joeljeske/reversi/schematics/GameBoardSchematic.png

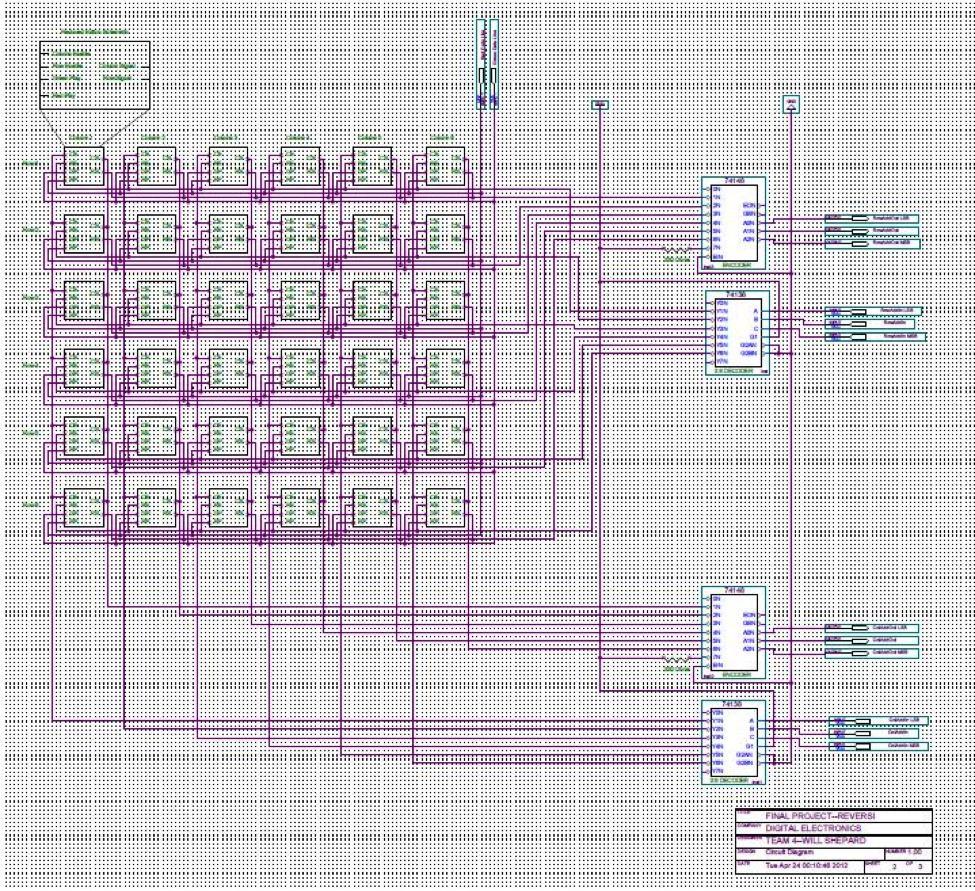
schematics/GameBoardSchematic.png
