joeljeske/reversi/schematics/CPLD-RAMSchematic.png

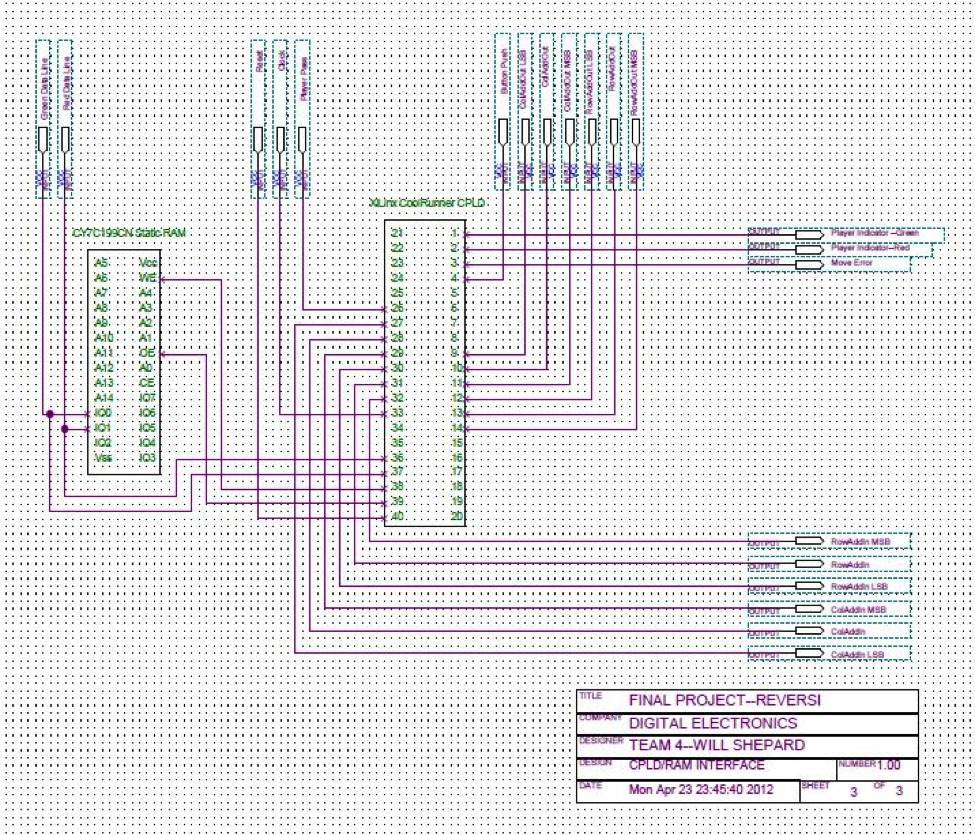
schematics/CPLD-RAMSchematic.png
