joeljeske/reversi/schematics/ButtonSchematic.png

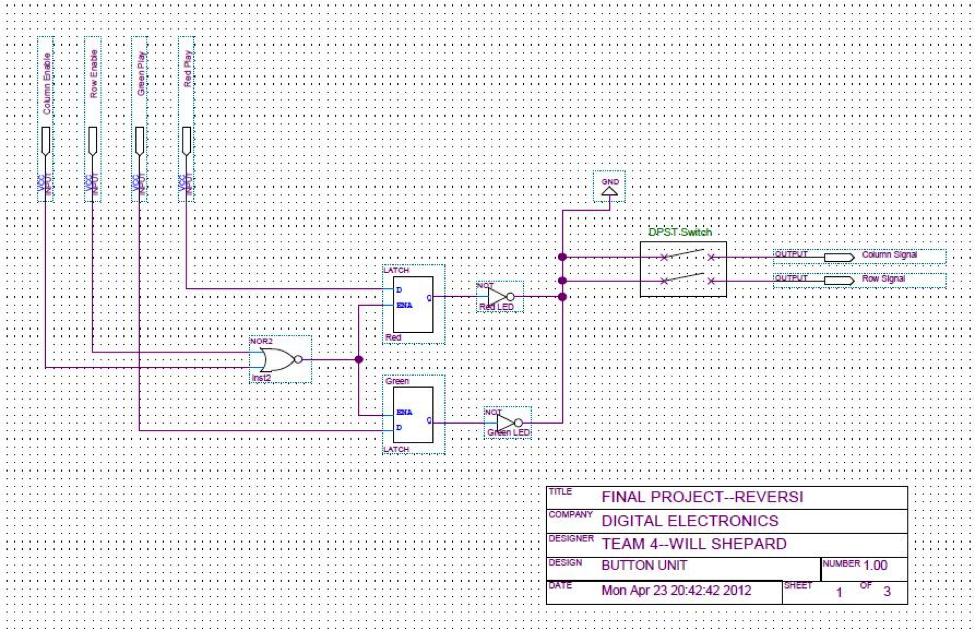
schematics/ButtonSchematic.png
